TeamPracticalProjects/WellSystemMonitor/GoogleAppsScripts/WSM Alert Webhook.png

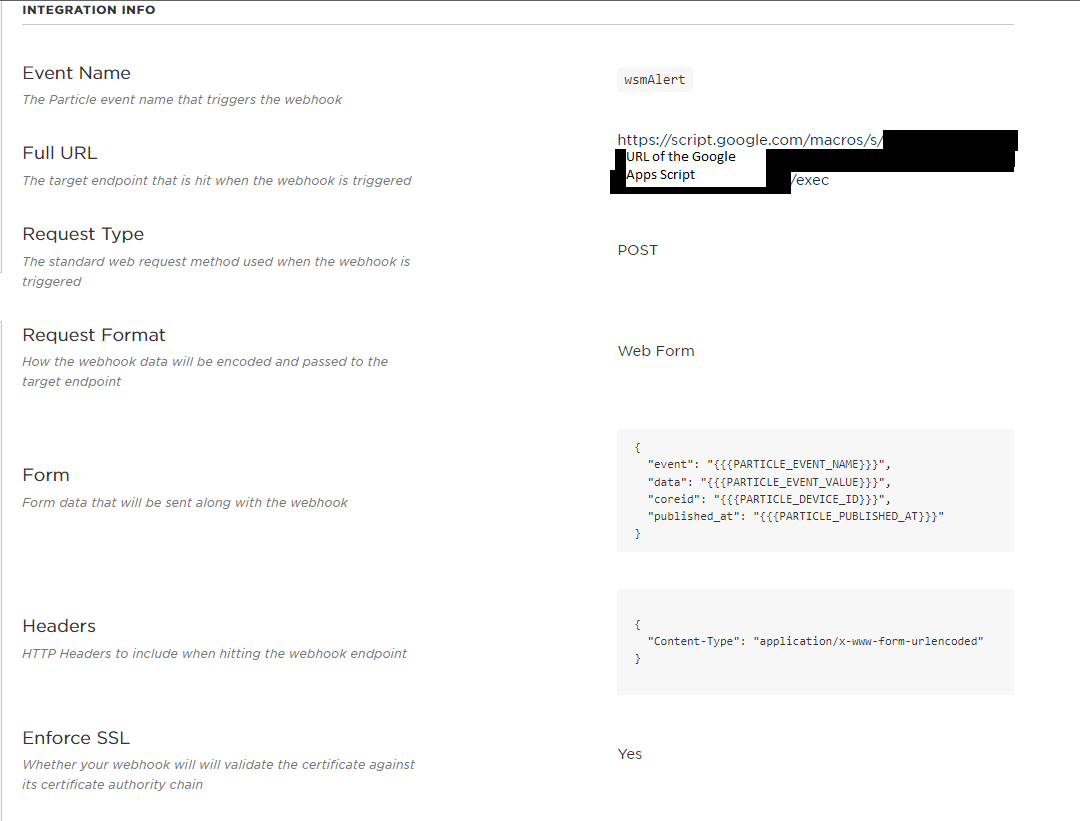
GoogleAppsScripts/WSM Alert Webhook.png
