TeamPracticalProjects/WellSystemMonitor/GoogleAppsScripts/WSM Event Webhook.png

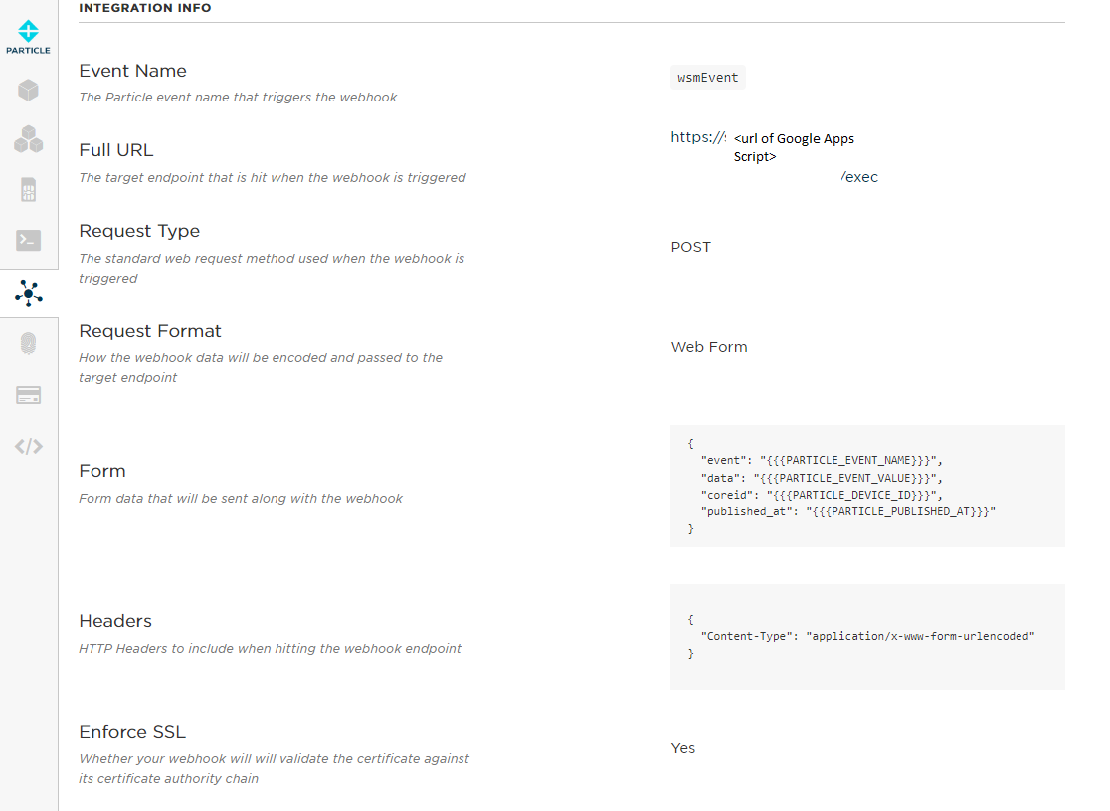
GoogleAppsScripts/WSM Event Webhook.png
