TeamPracticalProjects/WellSystemMonitor/(threads)

Thread 18 (2022-09-30):

ENH: Heartbeat  notification

jschrempp, 2022-09-30:
Now that the code has alarms, there is a chance that we will remove the WP notifications because they are annoying. With these gone, how will the user be assured that the monitoring system is active? The user could always look at the logging spreadsheet to see that new events are being added.

The proposal is to add a weekly heartbeat notification. In that it would report: number of well pump cycles since the last heartbeat; number of pressure pump cycles since the last heartbeat; number of days the WSM has been up and running (days since last reboot). This weekly heartbeat text would be less annoying yet provide assurance that the WSM is still alive.

Thread 23 (2022-10-28):

ENH: Well Pump alert only signals when pump stops

jschrempp, 2022-10-28:
The current design: When the well pump stops running, the run time is compared to a limit. If the limit is exceeded, then an alert is sent.

Imagine the situation where the pipe between the well head and the reservoir is broken. When the well pump comes on it will run forever because the reservoir is never filled to the point that the float switch will turn off the pump. In this case I think the system owner would like to get an alert when the pump has run longer than the set limit, even if the well pump is still running.

To do this the code would need to remember the last well pump ON event and each time it checks for the limit the code will compute how long the well pump has been running and trigger an alert even though the well pump is still running. Maybe there will be two alerts:
"well pump has been running longer than XX minutes" and "well pump has run for YY minutes".
