TeamPracticalProjects/WellSystemMonitor/(commit log)

2018-08-16 sensors working. blynk not tested
2018-09-07 Added App Code
    Created a TestApp directory with subdirectories for "src", "executable",
    and "docs". The compiled (.apk) file is in "executable" and the App
    Inventor source file (.aia) is in "src". A user document will be added
    to "docs" later. The code has been compiled for e-mail or USB loading
    to an android device and not for the Google Play Store compatibility.
    The app has been tested and appears to work well. It does not process
    the toggle switch data, however.
2018-09-11 indicator light now on after boot. Off when button is pressed. Blinks when not connected to cloud.
2018-09-19 moved t/h reports to 30 minutes. Inverted pump status to correspond to normally open relay contacts.
    [WellSystemMonitor.ino]
2018-09-21 corrected bug in the inversion of pump sensor state
    [WellSystemMonitor.ino]
2018-09-21 Updated Test App
    Updated test app to reflect the changed state reporting by the Particle
    firmware (both source and .apk files). Added comments to the pump
    status display logic in the source code to indicate the firmware state
    associated with the pump state.
2018-09-22 Updated documents
    Updated the WSM Build document. All documents have been reviewed and
    updated to reflect the use of normally open relay contacts.
2018-12-19 Fix for Indicator randomly turning off
    I found the bug and this firmware version (1.1) fixes it. The bug was
    in loop() circa line 259. There is a test for not being connected to
    the Particle cloud and if it is true (not connected), the indicator is
    flashed. This test can end anytime the device reconnects to the cloud
    and can leave the indicator in the off state because there is no code to
    retest the pushbutton state until the latter changes. I added an "else"
    in line 261 which tests the current status of the pushbutton and sets
    the indicator accordingly.
    [WellSystemMonitor.ino]
2018-12-21 Version 1.2 of the firmware
    Added one line of code to enable the system thread. With the system
    thread enabled, the firmware can detect loss of communication with the
    Particle cloud and will flash the button indication in this event. When
    cloud connection is restored, the indicator returns to normal operation.
2019-08-28 now set antenna selection to auto
2021-05-14 System Update and Bug Fix
    Added DHT.begin() to setup() to initialize the DHT sensor, per Particle OS updated in 2019. Updated the DHT library to the latest version and updated Particle OS version to 3.0.0. Updated comments to reflect these changes.
    [WellSystemMonitor.ino]
2021-06-06 Test firmware
    This firmware tests the Google Apps Script API. It contains functions to create the correct strings for publication. These functions can be re-used in the release WSM firmware.
    [SheetAPI_Test.ino]
2021-06-13 Partial implementation of new features
    Implemented and tested new features of computing and recording pump on time. Need to change the wp on time to /60 for minutes. Need to work on local timestamp.
2022-08-17 WIP
    Alerts not working right. Almost as if the begin() isn't executing properly
    [WSMAlertProcessor.cpp, WellSystemMonitor.ino]
2022-08-24 Bug Fixes
    Fixed initialization of PP and WP in the .ino file. Now don't generate spurious alerts upon bootup. Also found bug in Alert (.cpp) file - used wrong accumulator for PP didn't run for 1 day alert. Now does not generate spurious alert upon bootup.
    [WSMAlertProcessor.cpp, WSMAlertProcessor.h, WellSystemMonitor.ino]
2022-09-28 added folder for google files
    [WSMData.ods]
